tetious/prusa-i3-glkl/openscad-files/output/extras/wade-gears.stl

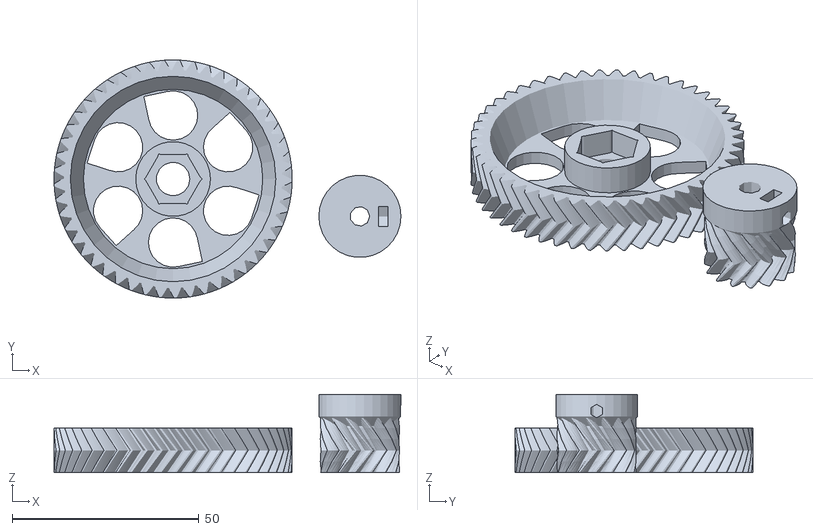
[picture p17: CAD file, 2014-08-11]
openscad-files/output/extras/wade-gears.stl
92.9 x 63.7 x 21.0
