tetious/prusa-i3-glkl/openscad-files/output/y-drivetrain.stl

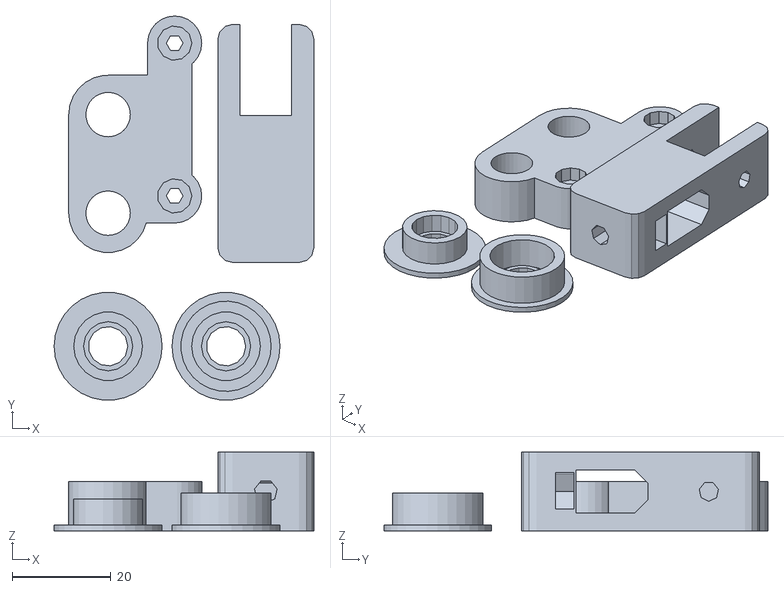
[picture p18: CAD file, 2014-08-11]
openscad-files/output/y-drivetrain.stl
52.7 x 77.9 x 16.0
