tetious/prusa-i3-glkl/openscad-files/sample_stls/big_htd3_lm12luu/extras/calibrate.stl

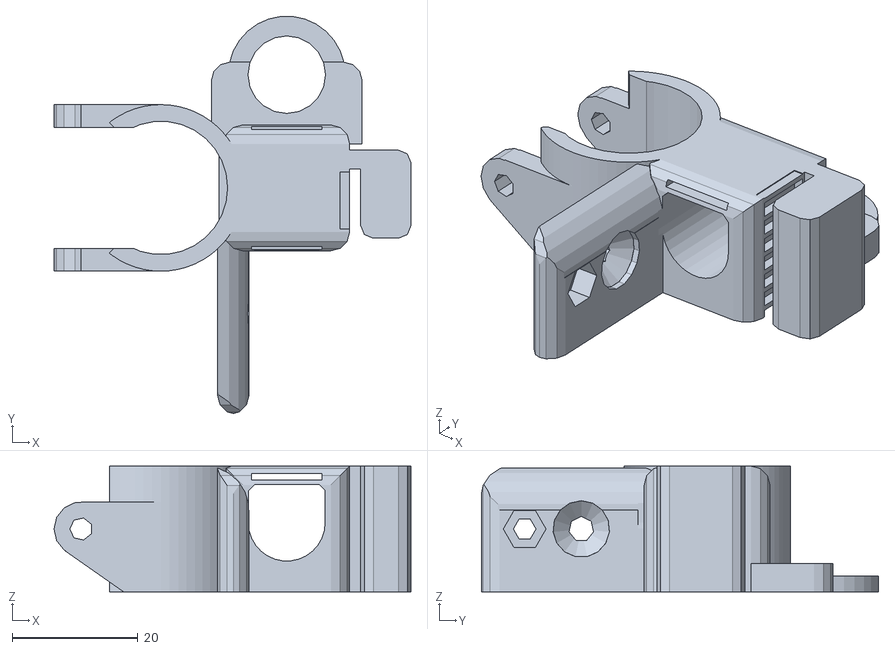
[picture p19: CAD file, 2014-08-11]
openscad-files/sample_stls/big_htd3_lm12luu/extras/calibrate.stl
56.8 x 63.1 x 20.0
