tetious/prusa-i3-glkl/openscad-files/sample_stls/big_htd3_lm12luu/z-axis.stl

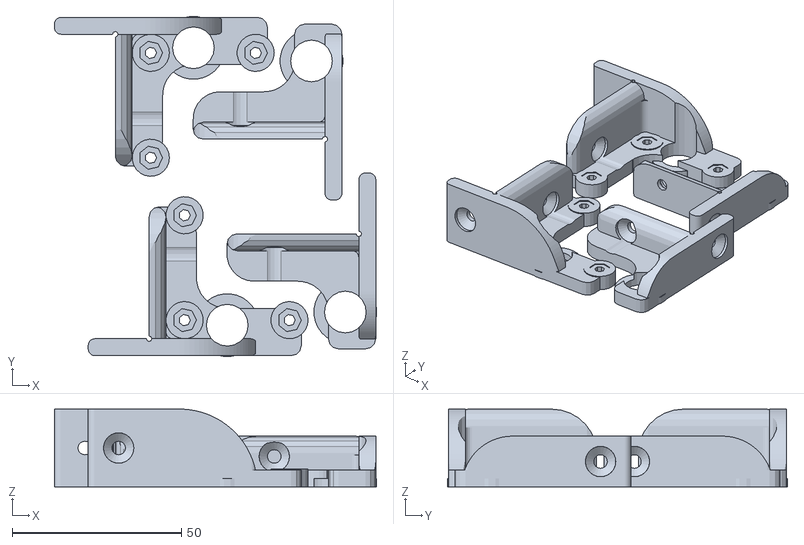
[picture p20: CAD file, 2014-08-11]
openscad-files/sample_stls/big_htd3_lm12luu/z-axis.stl
95.2 x 100.5 x 23.0
