tetious/prusa-i3-glkl/openscad-files/sample_stls/default_box_gt2_lm10uu/extras/tube_clamp.stl

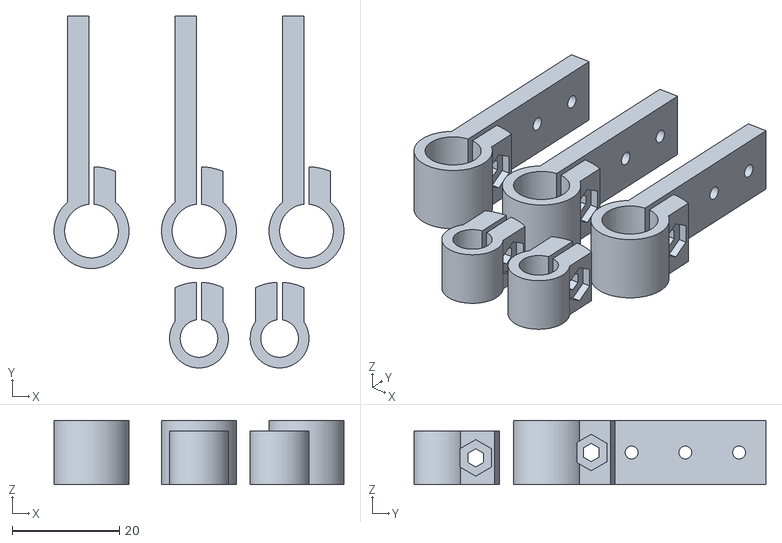
[picture p21: CAD file, 2014-08-11]
openscad-files/sample_stls/default_box_gt2_lm10uu/extras/tube_clamp.stl
54.0 x 65.5 x 12.0
