tetious/prusa-i3-glkl/openscad-files/sample_stls/default_box_gt2_lm10uu/x-carriage.stl

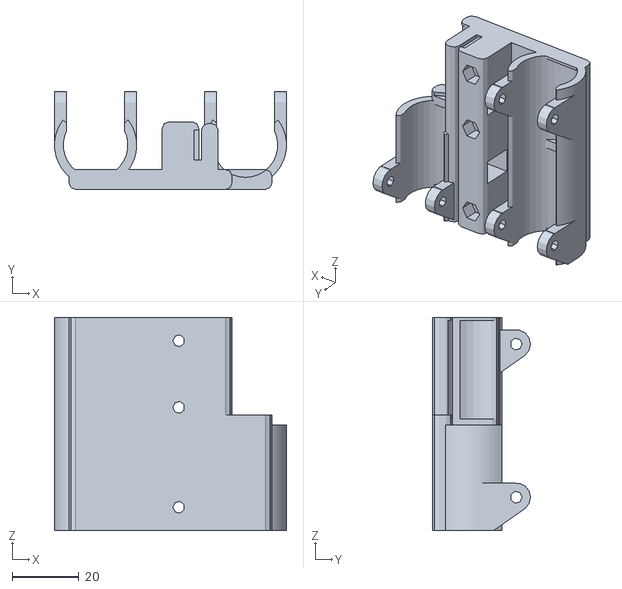
[picture p22: CAD file, 2014-08-11]
openscad-files/sample_stls/default_box_gt2_lm10uu/x-carriage.stl
69.7 x 29.4 x 64.0
