tetious/prusa-i3-glkl/openscad-files/sample_stls/single_plate_gt2_lm8uu/extras/gregs-wade-v3.stl

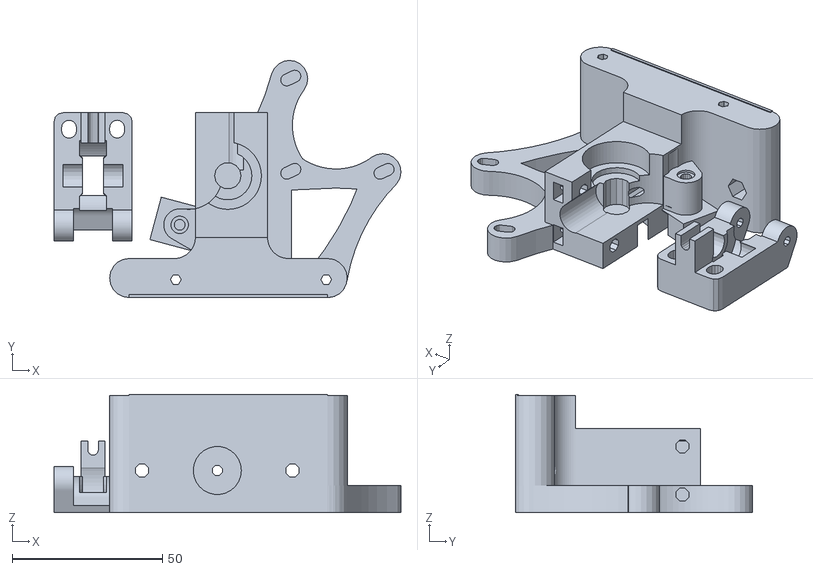
[picture p23: CAD file, 2014-08-11]
openscad-files/sample_stls/single_plate_gt2_lm8uu/extras/gregs-wade-v3.stl
115.4 x 78.9 x 39.3
