tetious/prusa-i3-glkl/openscad-files/sample_stls/single_plate_gt2_lm8uu/x-end.stl

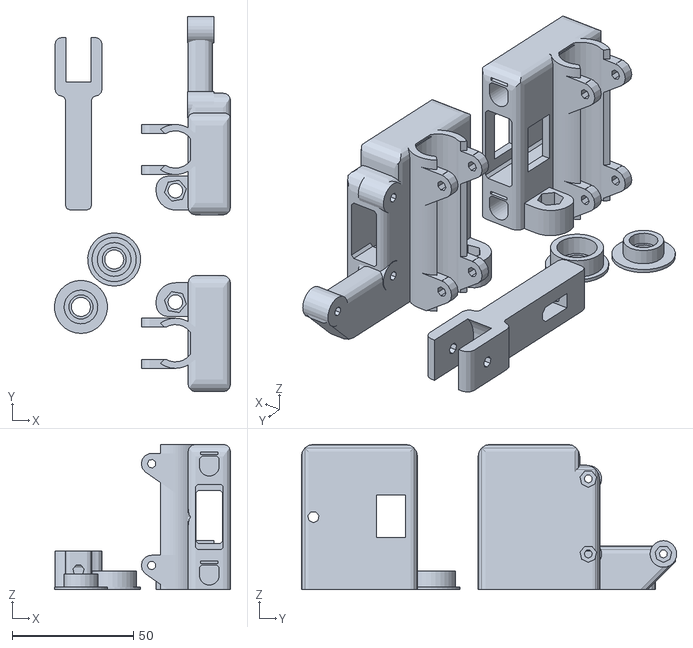
[picture p24: CAD file, 2014-08-11]
openscad-files/sample_stls/single_plate_gt2_lm8uu/x-end.stl
72.7 x 155.0 x 60.0
