tetious/prusa-i3-glkl/openscad-files/output/bushing.stl

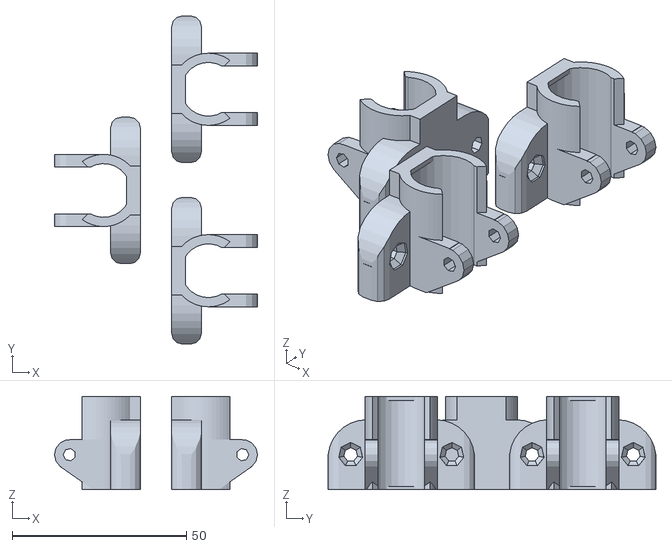
[picture p25: CAD file, 2014-08-11]
openscad-files/output/bushing.stl
58.2 x 94.0 x 26.7
