tetious/prusa-i3-glkl/openscad-files/output/extras/tube_clamp.stl

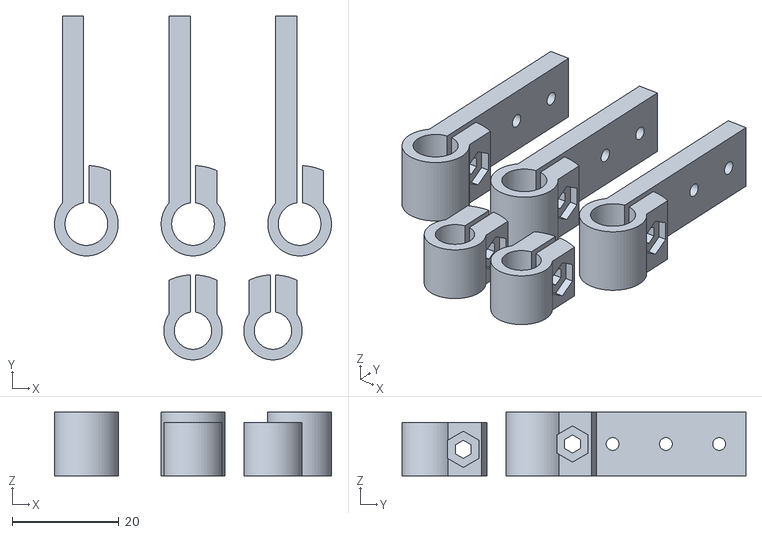
[picture p26: CAD file, 2014-08-11]
openscad-files/output/extras/tube_clamp.stl
52.0 x 64.5 x 12.0
