tetious/prusa-i3-glkl/openscad-files/sample_stls/big_htd3_lm12luu/extras/tube_clamp.stl

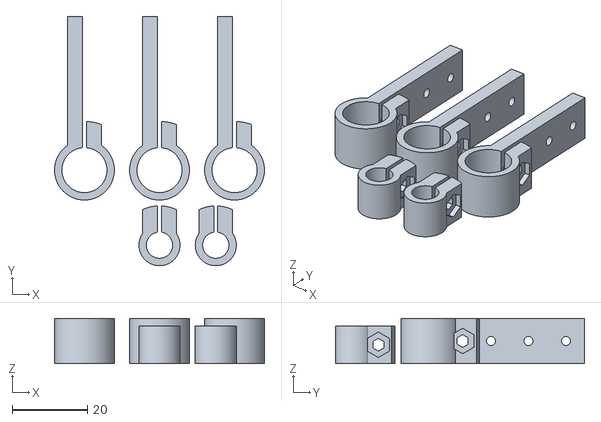
[picture p27: CAD file, 2014-08-11]
openscad-files/sample_stls/big_htd3_lm12luu/extras/tube_clamp.stl
56.0 x 66.5 x 12.0
