tetious/prusa-i3-glkl/openscad-files/sample_stls/big_htd3_lm12luu/y-axis-bracket.stl

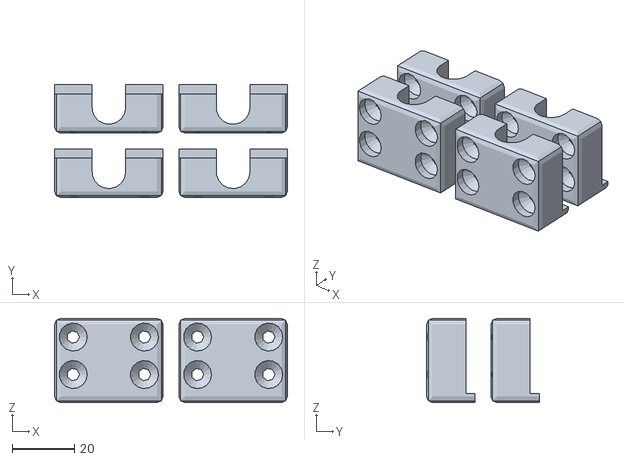
[picture p28: CAD file, 2014-08-11]
openscad-files/sample_stls/big_htd3_lm12luu/y-axis-bracket.stl
74.6 x 36.2 x 27.0
