tetious/prusa-i3-glkl/openscad-files/sample_stls/default_box_gt2_lm10uu/extras/calibrate.stl

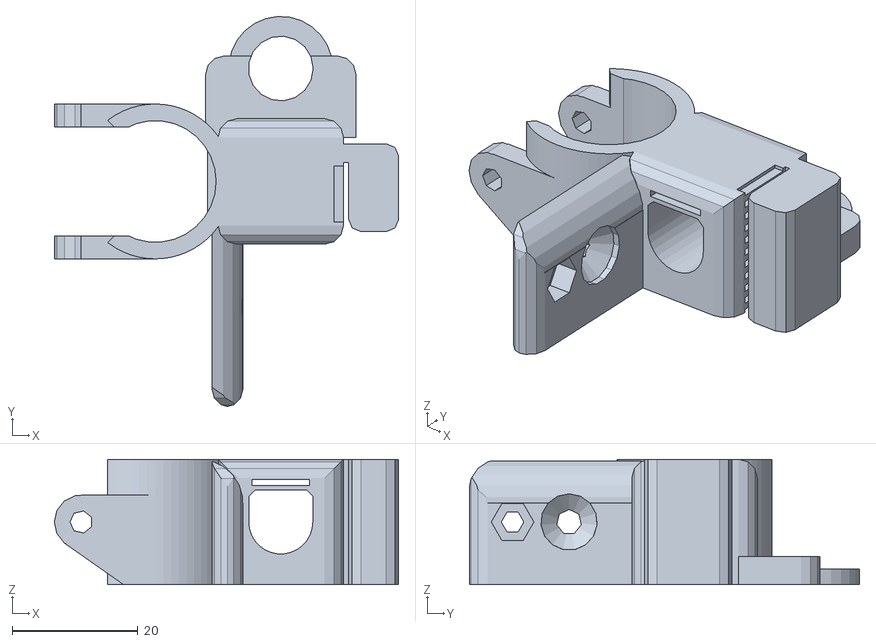
[picture p29: CAD file, 2014-08-11]
openscad-files/sample_stls/default_box_gt2_lm10uu/extras/calibrate.stl
54.9 x 62.2 x 20.0
