tetious/prusa-i3-glkl/openscad-files/sample_stls/single_plate_gt2_lm8uu/extras/calibrate.stl

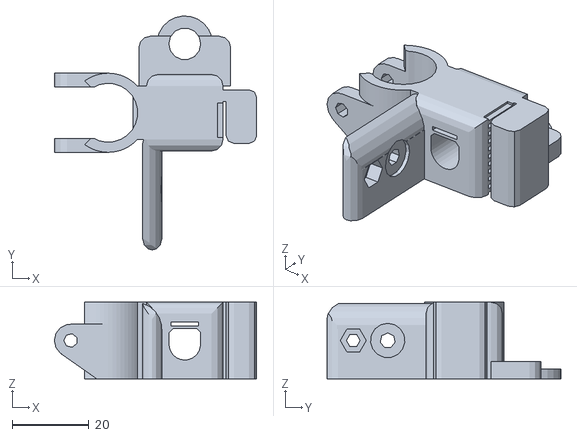
[picture p30: CAD file, 2014-08-11]
openscad-files/sample_stls/single_plate_gt2_lm8uu/extras/calibrate.stl
52.9 x 61.1 x 20.0
