tetious/prusa-i3-glkl/openscad-files/sample_stls/single_plate_gt2_lm8uu/y-belt-holder.stl

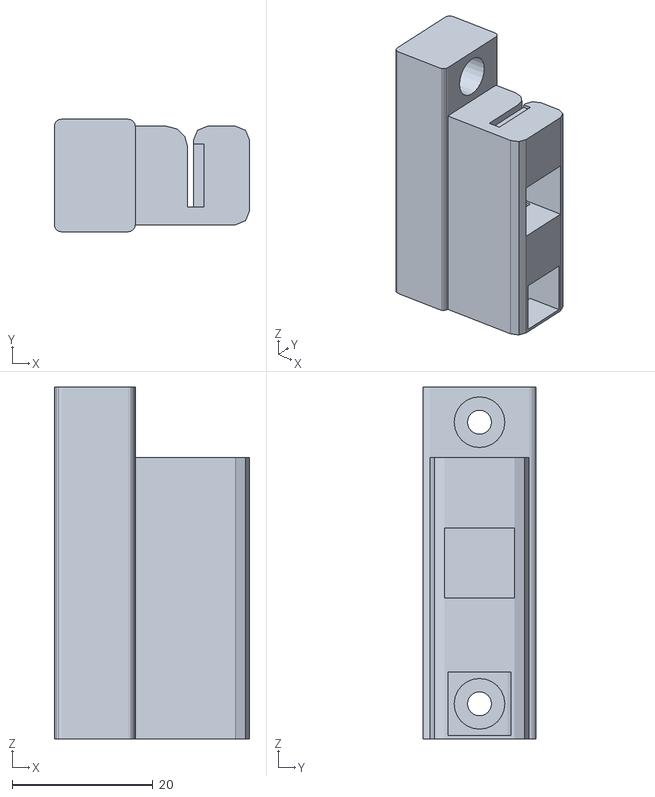
[picture p31: CAD file, 2014-08-11]
openscad-files/sample_stls/single_plate_gt2_lm8uu/y-belt-holder.stl
27.8 x 16.0 x 50.0
