tetious/prusa-i3-glkl/openscad-files/output/extras/bearing-holder-single-plate-y.stl

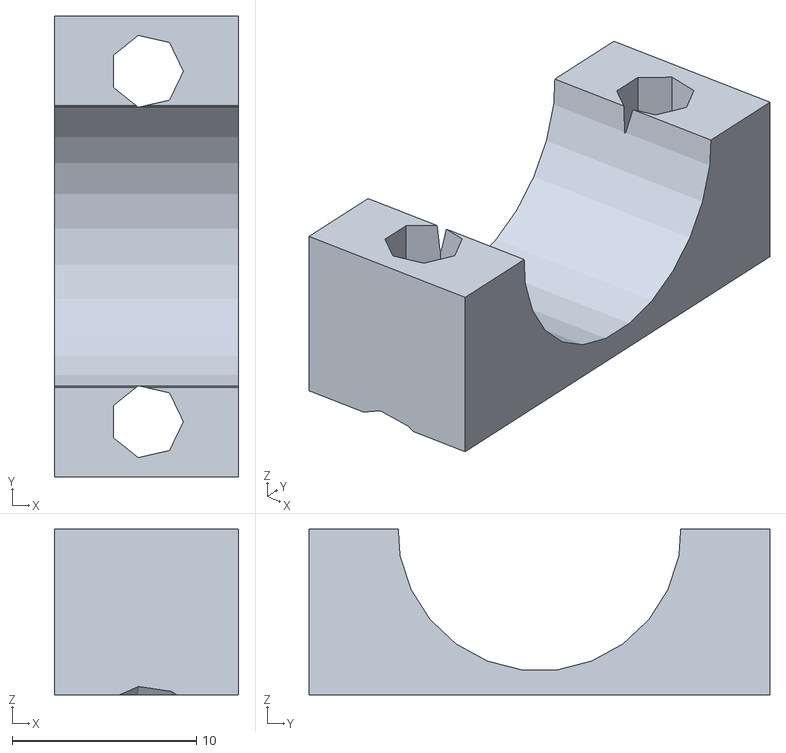
[picture p32: CAD file, 2014-08-11]
openscad-files/output/extras/bearing-holder-single-plate-y.stl
10.0 x 25.0 x 9.00
