tetious/prusa-i3-glkl/openscad-files/output/x-carriage.stl

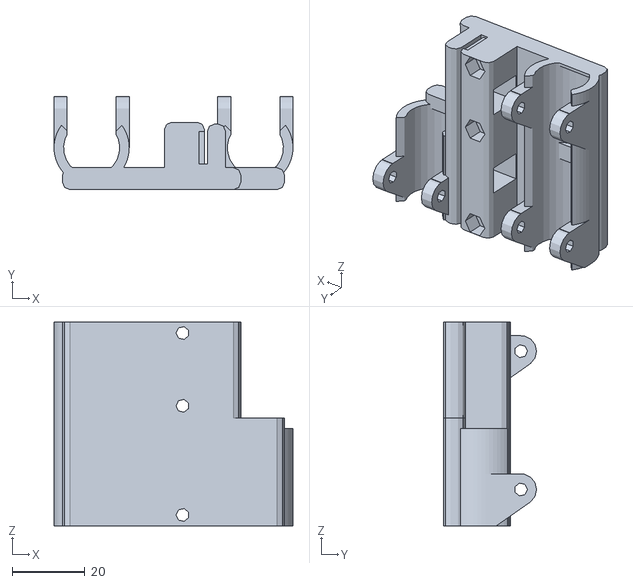
[picture p33: CAD file, 2014-08-11]
openscad-files/output/x-carriage.stl
65.7 x 25.6 x 56.0
