tetious/prusa-i3-glkl/openscad-files/sample_stls/big_htd3_lm12luu/y-drivetrain.stl

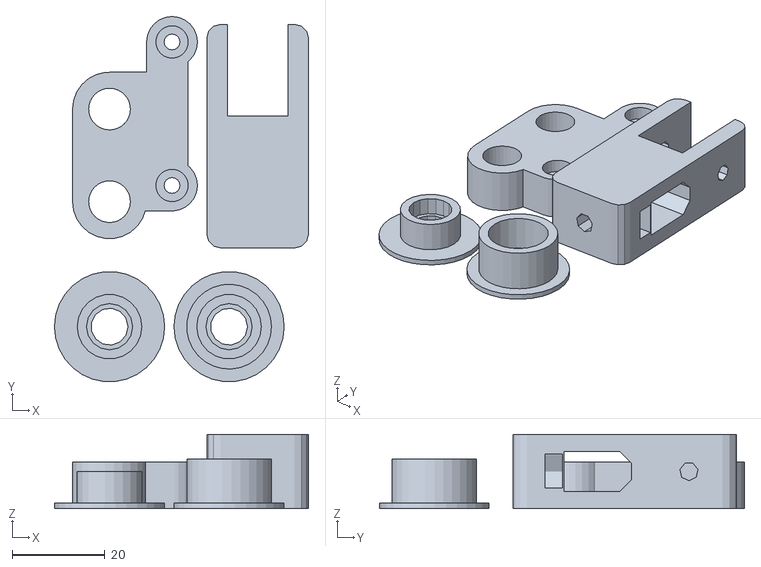
[picture p34: CAD file, 2014-08-11]
openscad-files/sample_stls/big_htd3_lm12luu/y-drivetrain.stl
54.9 x 78.8 x 16.0
