tetious/prusa-i3-glkl/openscad-files/sample_stls/default_box_gt2_lm10uu/y-belt-holder.stl

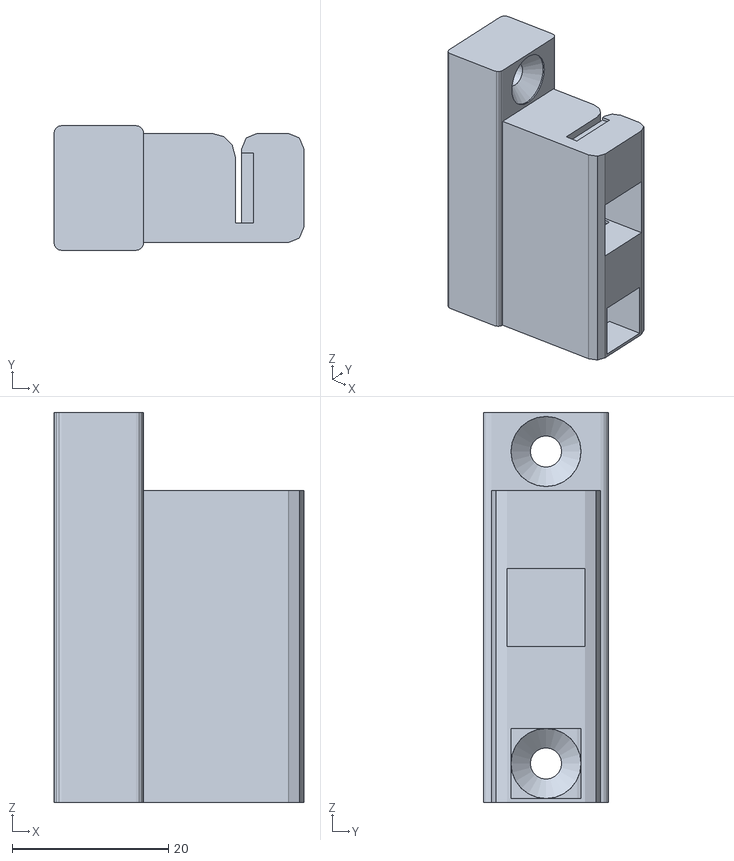
[picture p35: CAD file, 2014-08-11]
openscad-files/sample_stls/default_box_gt2_lm10uu/y-belt-holder.stl
32.0 x 16.0 x 50.0
