tetious/prusa-i3-glkl/openscad-files/output/y-axis-corner.stl

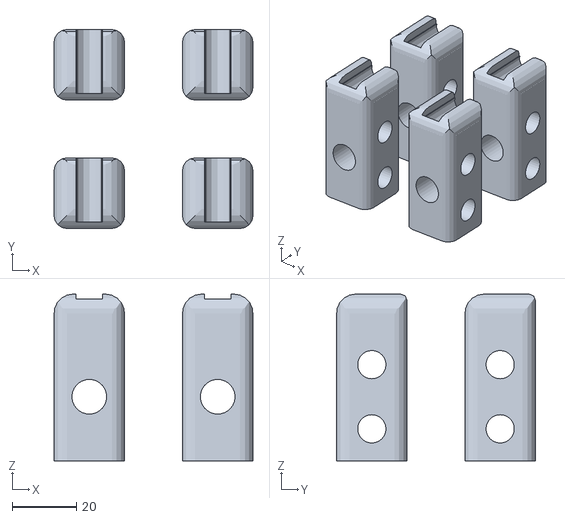
[picture p36: CAD file, 2014-08-11]
openscad-files/output/y-axis-corner.stl
62.0 x 62.0 x 52.0
