tetious/prusa-i3-glkl/openscad-files/sample_stls/big_htd3_lm12luu/x-carriage.stl

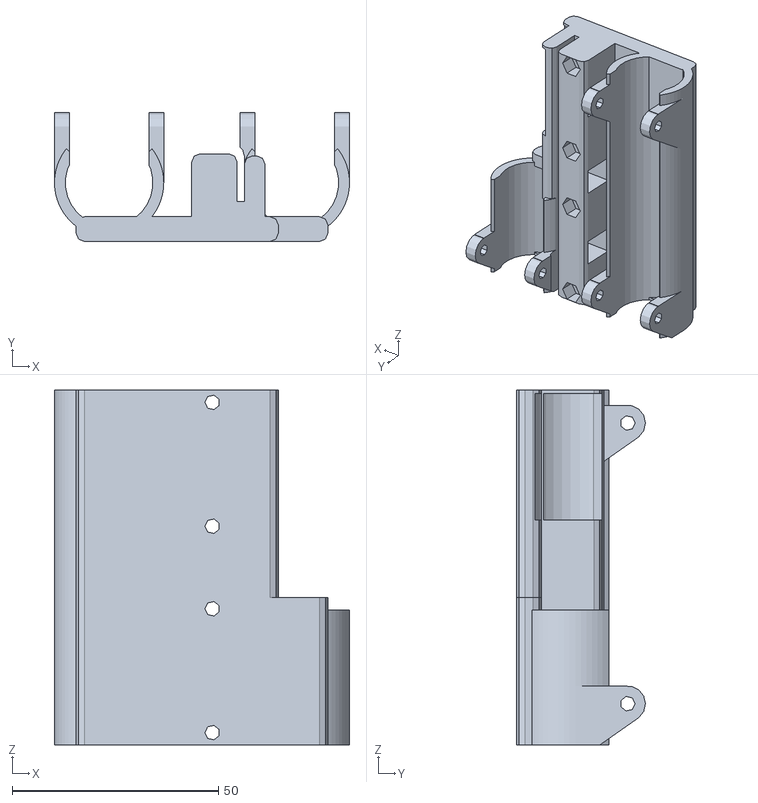
[picture p37: CAD file, 2014-08-11]
openscad-files/sample_stls/big_htd3_lm12luu/x-carriage.stl
71.5 x 31.2 x 86.0
