tetious/prusa-i3-glkl/openscad-files/sample_stls/single_plate_gt2_lm8uu/y-axis-corner.stl

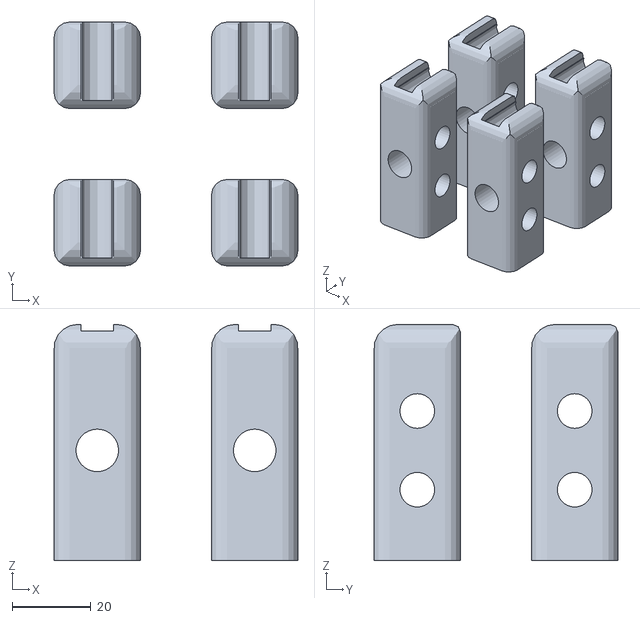
[picture p38: CAD file, 2014-08-11]
openscad-files/sample_stls/single_plate_gt2_lm8uu/y-axis-corner.stl
62.0 x 62.0 x 60.0
