tetious/prusa-i3-glkl/openscad-files/output/y-belt-holder.stl

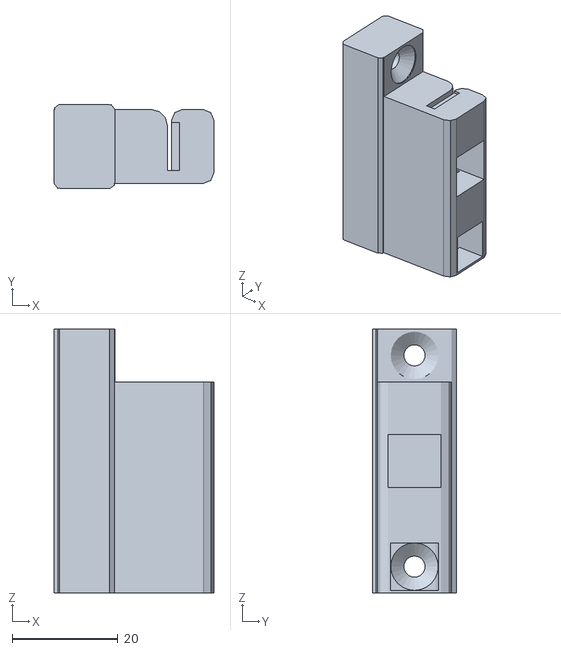
[picture p39: CAD file, 2014-08-11]
openscad-files/output/y-belt-holder.stl
30.2 x 16.0 x 50.0
