tetious/prusa-i3-glkl/openscad-files/sample_stls/big_htd3_lm12luu/y-belt-holder.stl

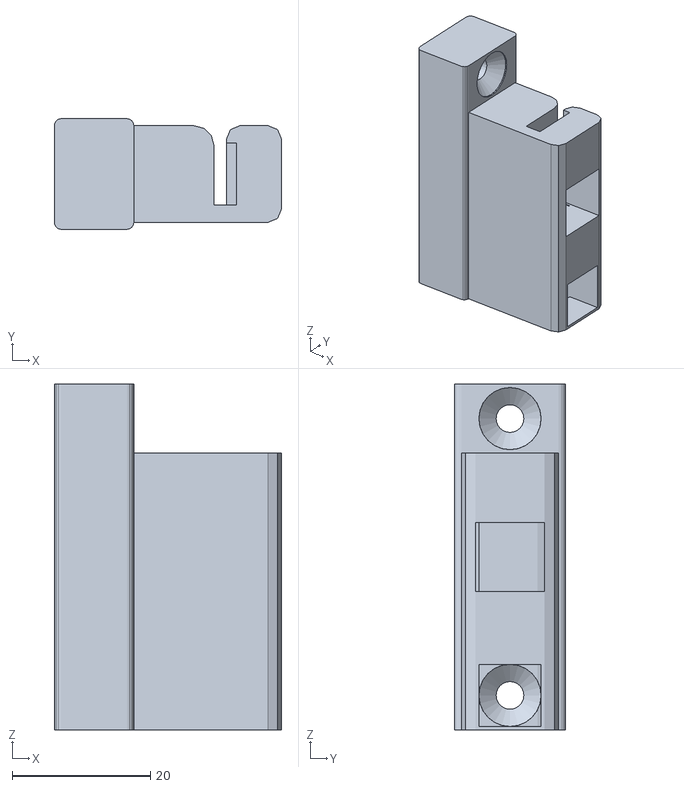
[picture p40: CAD file, 2014-08-11]
openscad-files/sample_stls/big_htd3_lm12luu/y-belt-holder.stl
32.9 x 16.0 x 50.0
