tetious/prusa-i3-glkl/openscad-files/sample_stls/default_box_gt2_lm10uu/x-end.stl

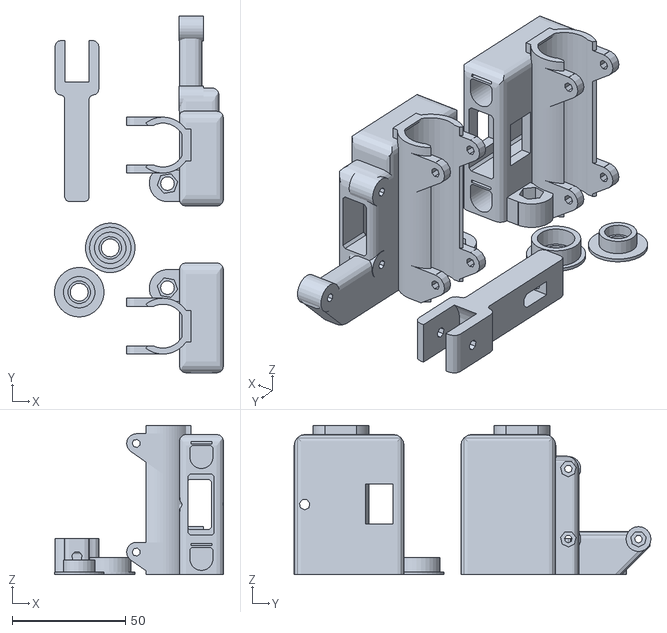
[picture p41: CAD file, 2014-08-11]
openscad-files/sample_stls/default_box_gt2_lm10uu/x-end.stl
74.7 x 157.7 x 66.0
