tetious/prusa-i3-glkl/openscad-files/sample_stls/single_plate_gt2_lm8uu/z-axis.stl

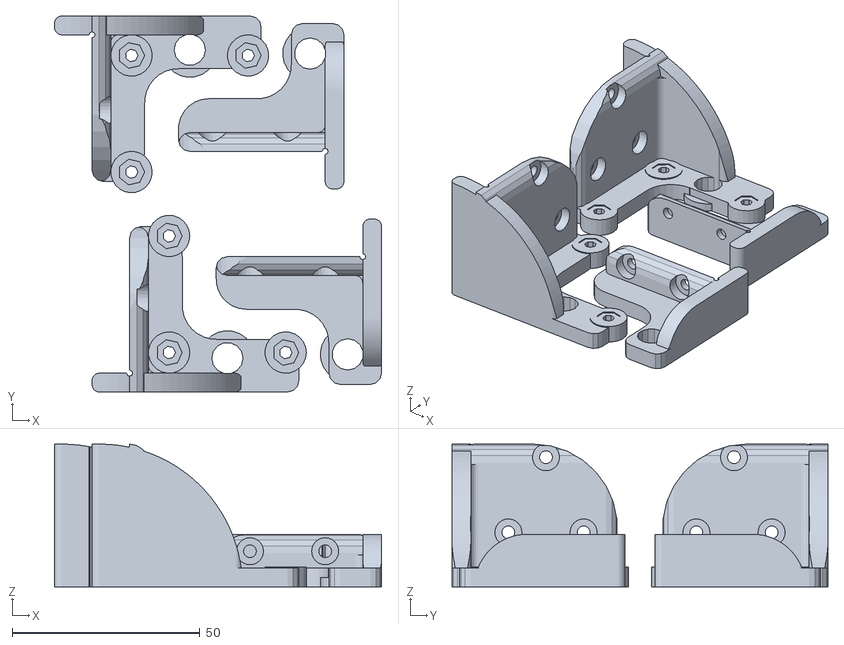
[picture p42: CAD file, 2014-08-11]
openscad-files/sample_stls/single_plate_gt2_lm8uu/z-axis.stl
87.0 x 100.0 x 38.0
