tetious/prusa-i3-glkl/openscad-files/output/extras/endstop-holder-extra.stl

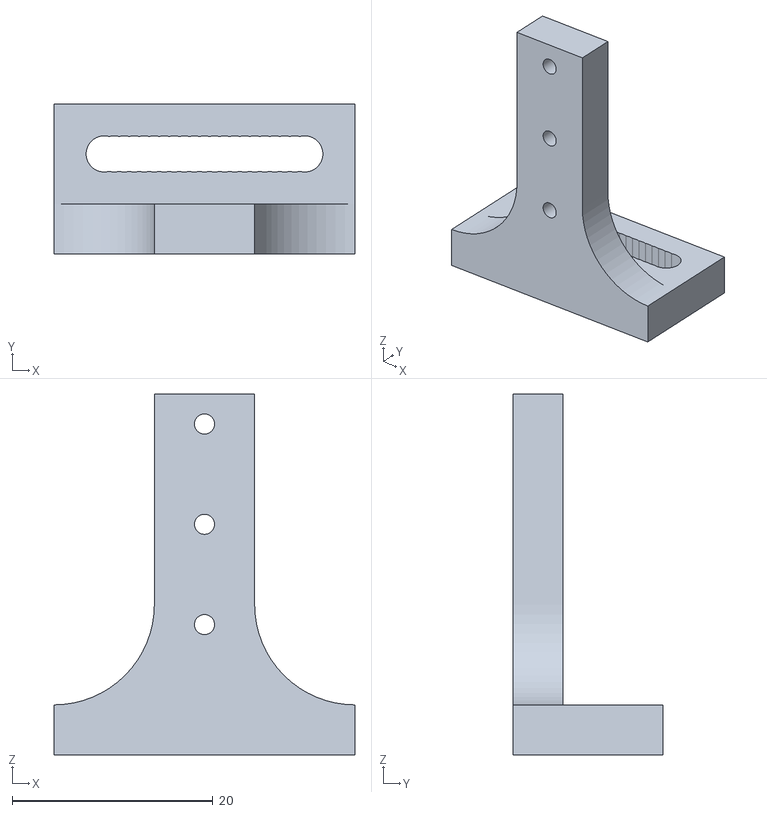
[picture p43: CAD file, 2014-08-11]
openscad-files/output/extras/endstop-holder-extra.stl
30.0 x 15.0 x 36.0
