tetious/prusa-i3-glkl/openscad-files/sample_stls/big_htd3_lm12luu/x-end.stl

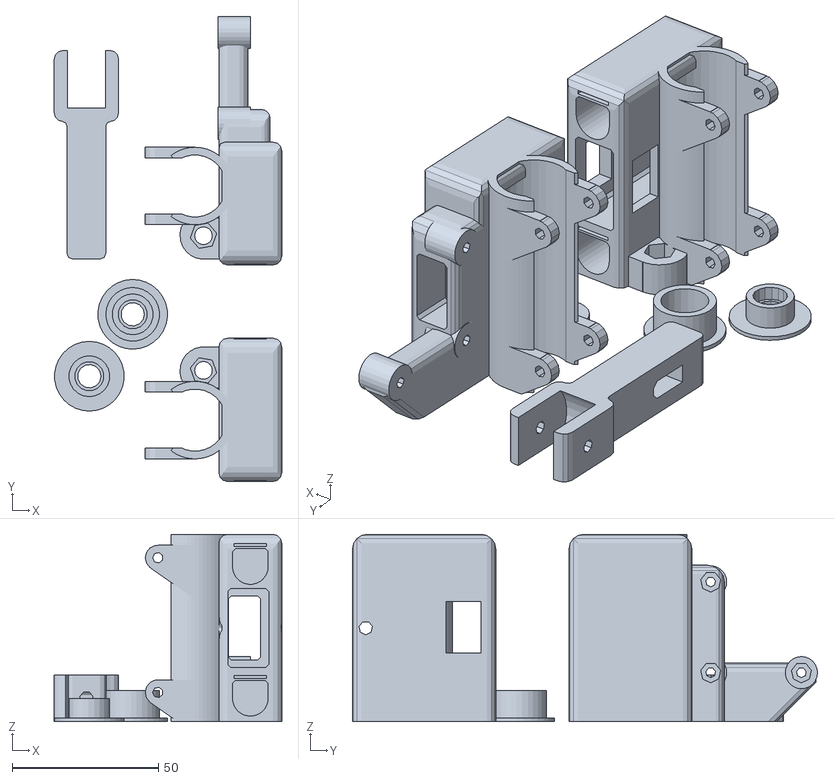
[picture p44: CAD file, 2014-08-11]
openscad-files/sample_stls/big_htd3_lm12luu/x-end.stl
77.8 x 158.9 x 64.0
