tetious/prusa-i3-glkl/openscad-files/output/z-axis.stl

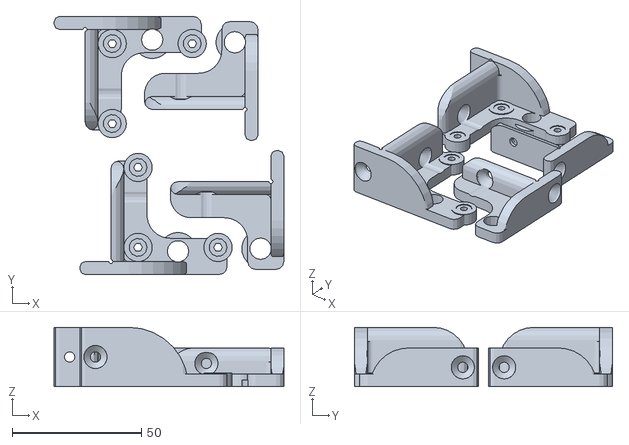
[picture p45: CAD file, 2014-08-11]
openscad-files/output/z-axis.stl
89.0 x 100.0 x 23.0
