tetious/prusa-i3-glkl/openscad-files/sample_stls/big_htd3_lm12luu/bushing.stl

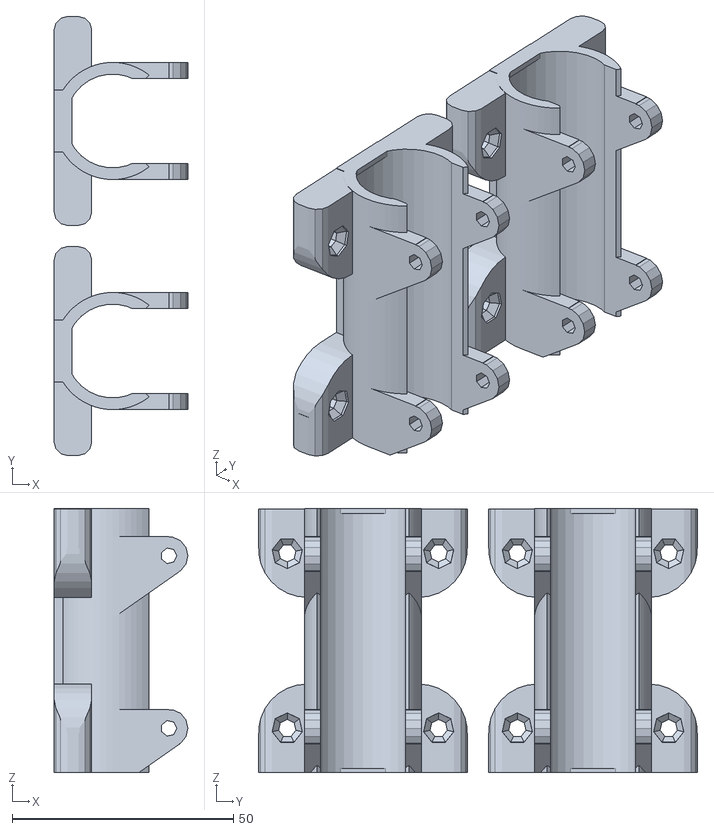
[picture p46: CAD file, 2014-08-11]
openscad-files/sample_stls/big_htd3_lm12luu/bushing.stl
30.2 x 99.2 x 59.7
