tetious/prusa-i3-glkl/openscad-files/sample_stls/default_box_gt2_lm10uu/bushing.stl

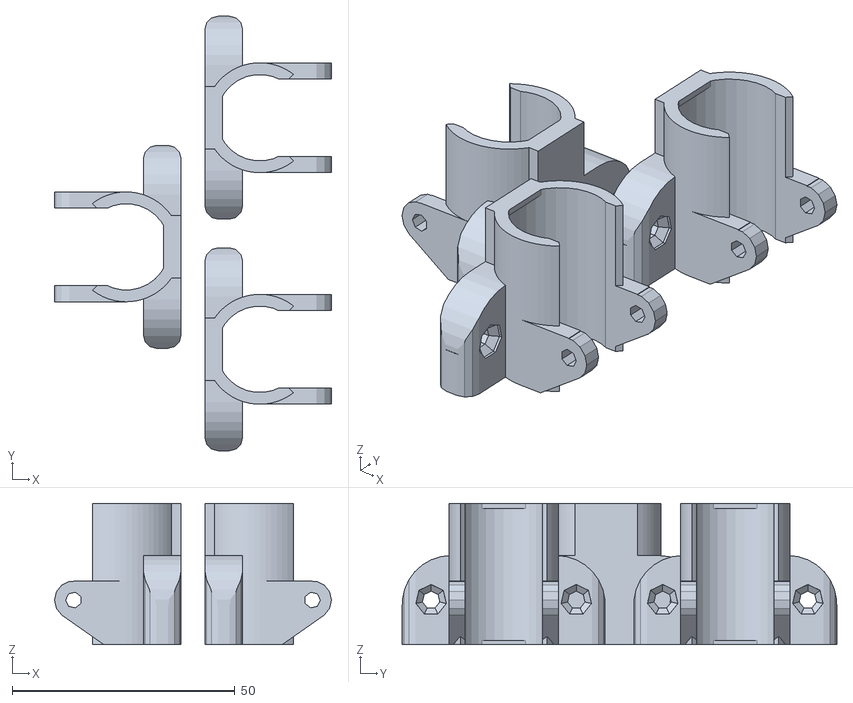
[picture p47: CAD file, 2014-08-11]
openscad-files/sample_stls/default_box_gt2_lm10uu/bushing.stl
62.2 x 97.6 x 31.7
