tetious/prusa-i3-glkl/openscad-files/output/extras/groovemount.stl

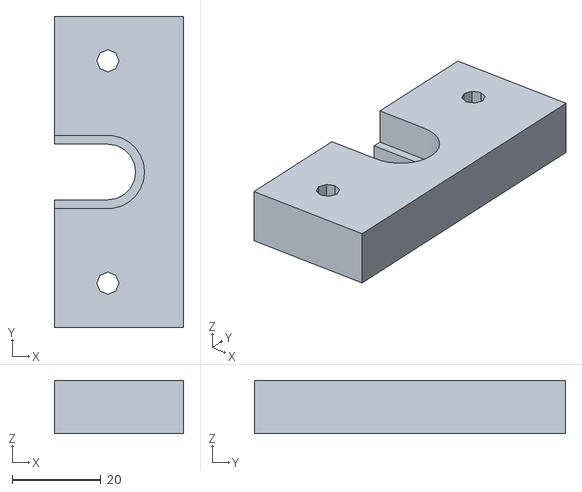
[picture p48: CAD file, 2014-08-11]
openscad-files/output/extras/groovemount.stl
29.0 x 70.0 x 12.0
