tetious/prusa-i3-glkl/openscad-files/output/extras/foldingclamp.stl

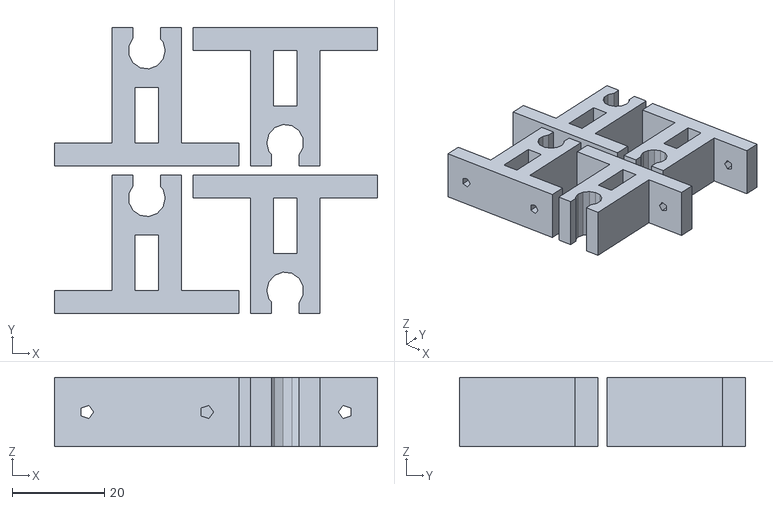
[picture p49: CAD file, 2014-08-11]
openscad-files/output/extras/foldingclamp.stl
70.0 x 62.0 x 15.0
