tetious/prusa-i3-glkl/openscad-files/output/extras/endstop-holder.stl

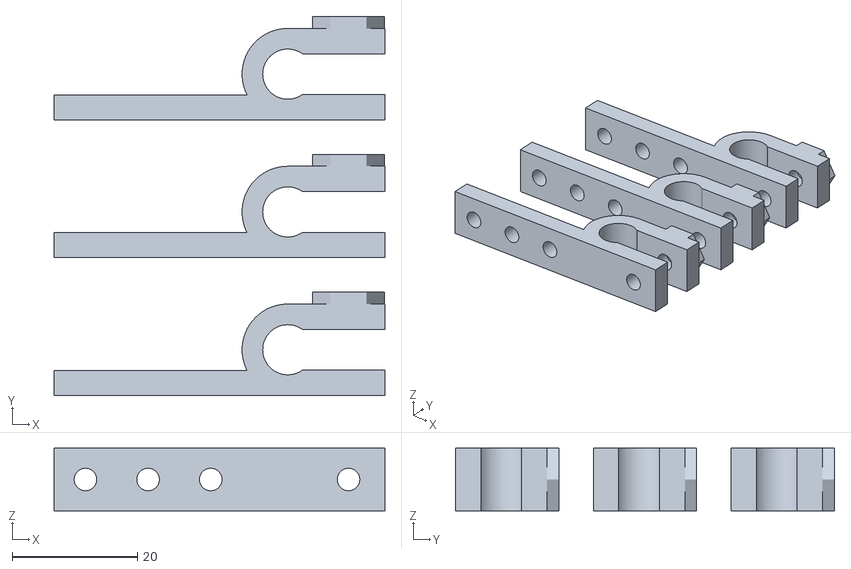
[picture p50: CAD file, 2014-08-11]
openscad-files/output/extras/endstop-holder.stl
52.8 x 60.5 x 10.0
