tetious/prusa-i3-glkl/(list of files, cad)

Other CAD files:
openscad-files/sample_stls/default_box_gt2_lm10uu/z-axis.stl
openscad-files/sample_stls/default_box_gt2_lm10uu/extras/gregs-wade-v3.stl
openscad-files/sample_stls/single_plate_gt2_lm8uu/extras/bearing-holder-single-plate-y.stl
openscad-files/sample_stls/single_plate_gt2_lm8uu/y-drivetrain.stl
openscad-files/output/extras/gregs-wade-v3-adjusted-size.stl
openscad-files/sample_stls/default_box_gt2_lm10uu/extras/wade-gears.stl
openscad-files/sample_stls/default_box_gt2_lm10uu/y-axis-bracket.stl
openscad-files/sample_stls/single_plate_gt2_lm8uu/extras/wade-gears.stl
openscad-files/output/extras/gregs-wade-v3.stl
openscad-files/sample_stls/single_plate_gt2_lm8uu/extras/tube_clamp.stl
openscad-files/output/y-axis-bracket.stl
openscad-files/sample_stls/default_box_gt2_lm10uu/y-drivetrain.stl
openscad-files/sample_stls/single_plate_gt2_lm8uu/x-carriage.stl
openscad-files/output/extras/calibrate.stl
openscad-files/output/x-end.stl
openscad-files/sample_stls/big_htd3_lm12luu/y-axis-corner.stl
openscad-files/sample_stls/default_box_gt2_lm10uu/y-axis-corner.stl
openscad-files/configuration.scad
openscad-files/inc/settings.scad
openscad-files/extras/inc/parametric_involute_gear_v5.0.scad
openscad-files/bushing.scad
openscad-files/doc/boxframe.scad
openscad-files/doc/complete-printer-plus.scad
openscad-files/doc/complete-printer.scad
openscad-files/extras/bearing-holder-single-plate-y.scad
openscad-files/extras/calibrate.scad
openscad-files/extras/endstop-holder-extra.scad
openscad-files/extras/endstop-holder.scad
openscad-files/extras/foldingclamp.scad
openscad-files/extras/groovemount.scad
openscad-files/extras/tube_clamp.scad
openscad-files/extras/wade-gears.scad
openscad-files/inc/bearing-guide.scad
openscad-files/inc/conf_bushing.scad
openscad-files/inc/functions.scad
openscad-files/inc/metric.scad
openscad-files/sample_stls/big_htd3_lm12luu/configuration.scad
openscad-files/sample_stls/default_box_gt2_lm10uu/configuration.scad
openscad-files/sample_stls/single_plate_gt2_lm8uu/configuration.scad
openscad-files/x-carriage.scad
openscad-files/x-end.scad
openscad-files/y-axis-bracket.scad
openscad-files/y-axis-corner.scad
openscad-files/y-belt-holder.scad
openscad-files/y-drivetrain.scad
openscad-files/z-axis.scad
