tetious/prusa-i3-glkl/(commit log)

2014-08-10 Initial checkin.
    [Configuration.h]
2014-08-11 Add openscad files and configuration.
    [bearing-guide.scad, bearing-holder-single-plate-y.scad, bearing-holder-single-plate-y.stl, boxframe.scad, bushing.scad, bushing.stl, calibrate.scad, calibrate.stl]
2014-08-11 calibration tweaks to some parameters
    [Configuration.h]
2014-08-11 Add back DEFAULT_MAX_FEEDRATE, and set Z to 3 instead of 5.
    [Configuration.h]
